jinsu1011/2026ESWContest_free_GaManItSeoDo-SANDI/final-report/README.md

# final-report

제24회 임베디드SW경진대회(2026) 자유공모 부문 **개발완료보고서** 제출본과
보고서에 사용한 원본 이미지 자산을 보관하는 폴더다.

| 파일 | 설명 |
|---|---|
| `2026ESWContest_자유공모_가만있어도SANDI_개발완료보고서.pdf` | 제출용 PDF (표지 1 + 본문 20 = 21페이지) |
| `assets/` | 보고서에 사용한 하드웨어·UI·3D 하우징 사진 및 렌더 |

`assets/` 주요 항목

| 파일 | 내용 |
|---|---|
| `hw_product_final.jpg`, `hw_product_full_crop.jpg` | 통합 완제품 외형 |
| `hw_product_full_emergency.jpg`, `hw_product_emergency_crop.jpg` | 긴급 상태 표시 |
| `hw_node_final.png` | 센서 노드 배선도 |
| `hw_esp32_wiring.jpg`, `hw_bench.jpg` | ESP32 실물 배선과 벤치 |
| `ui_lcd_1_normal_empty.jpg` ~ `ui_lcd_6_failed.jpg` | LCD 6개 상태 화면 |
| `ui_web.png` | 관리자 웹 화면 |
| `3d_*.png` | 3D 하우징 설계 렌더 (STL 원본은 `hardware/3d_models/`) |
| `thermal_spotcheck.jpg` | Thermal 현장 점검 |
| `qr_confined.png` | 게스트 대시보드 QR |
