jinsu1011/2026ESWContest_free_GaManItSeoDo-SANDI/final-report/assets/3d_lcd_housing_front.png

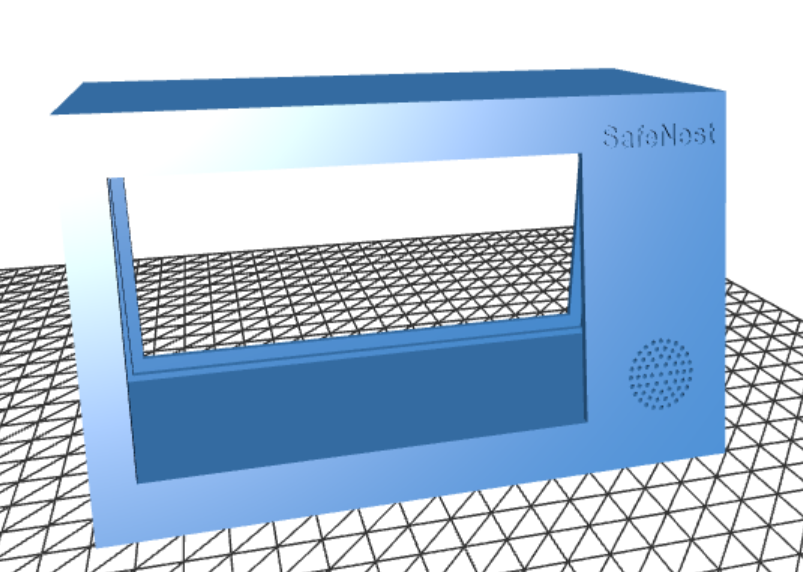
final-report/assets/3d_lcd_housing_front.png
