jinsu1011/2026ESWContest_free_GaManItSeoDo-SANDI/final-report/assets/3d_sensor_housing_sliding_back.png

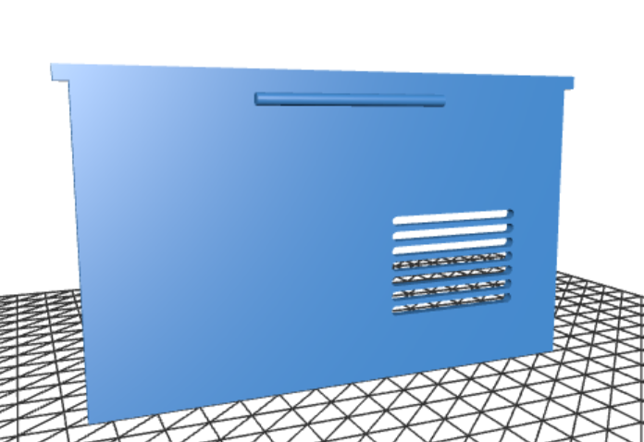
final-report/assets/3d_sensor_housing_sliding_back.png
