jinsu1011/2026ESWContest_free_GaManItSeoDo-SANDI/final-report/assets/3d_trapezoid_T_back_vent.png

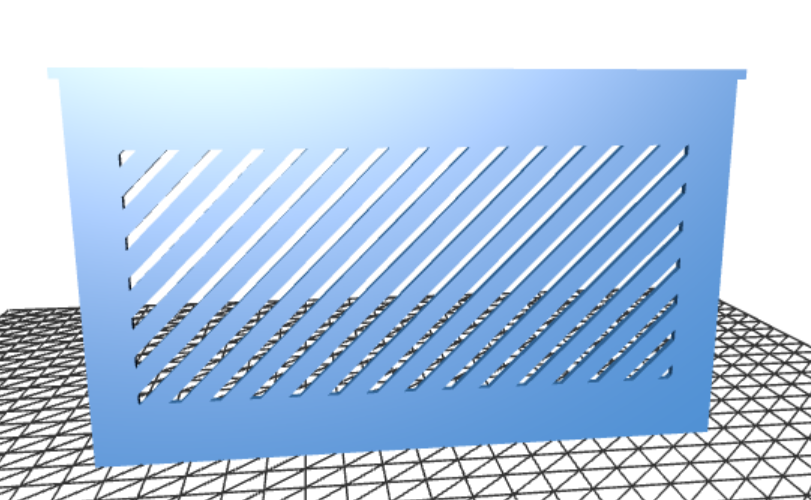
final-report/assets/3d_trapezoid_T_back_vent.png
