jinsu1011/2026ESWContest_free_GaManItSeoDo-SANDI/final-report/assets/hw_bench.jpg

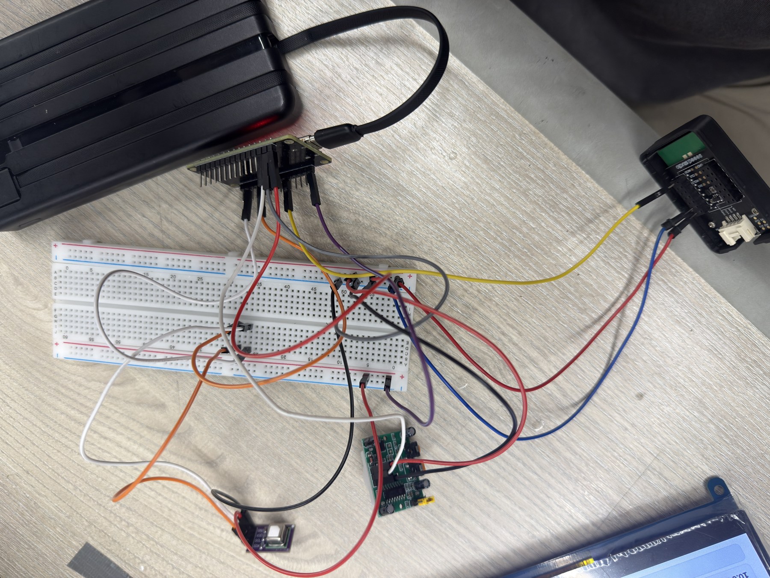
final-report/assets/hw_bench.jpg
