jinsu1011/2026ESWContest_free_GaManItSeoDo-SANDI/final-report/assets/hw_product_full_crop.jpg

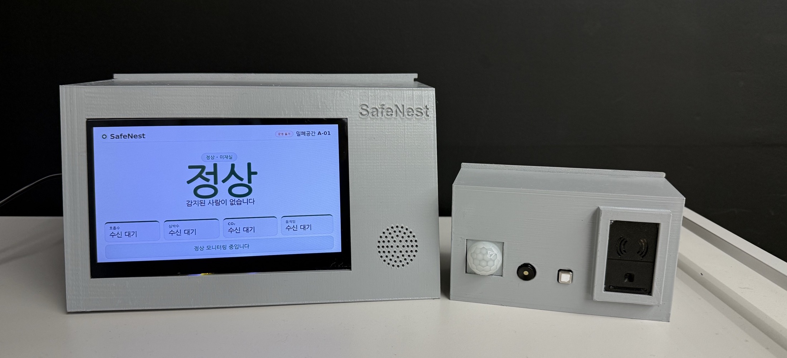
final-report/assets/hw_product_full_crop.jpg
