jinsu1011/2026ESWContest_free_GaManItSeoDo-SANDI/final-report/assets/qr_confined.png

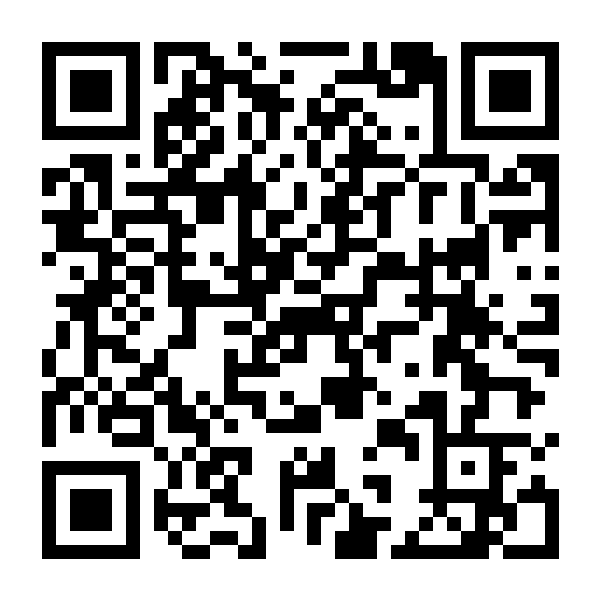
final-report/assets/qr_confined.png
