jinsu1011/2026ESWContest_free_GaManItSeoDo-SANDI/final-report/assets/thermal_spotcheck.jpg

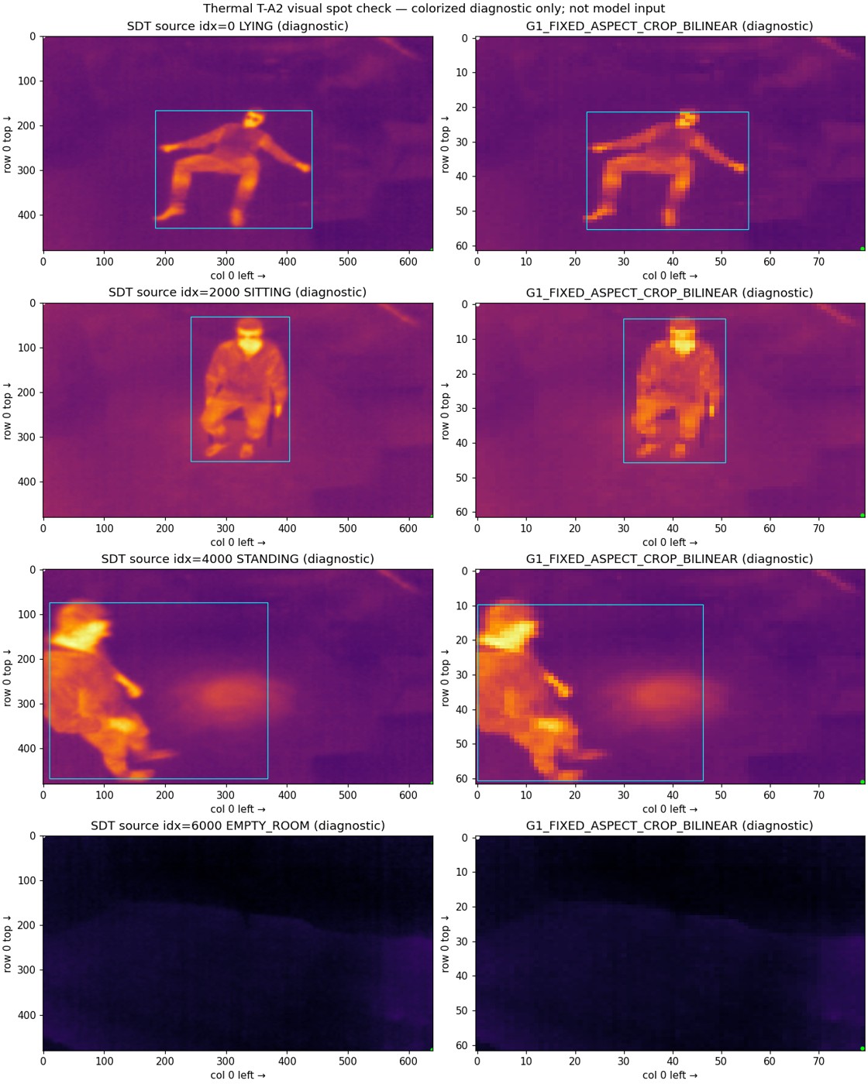
final-report/assets/thermal_spotcheck.jpg
