jinsu1011/2026ESWContest_free_GaManItSeoDo-SANDI/final-report/assets/ui_lcd_1_normal_empty.jpg

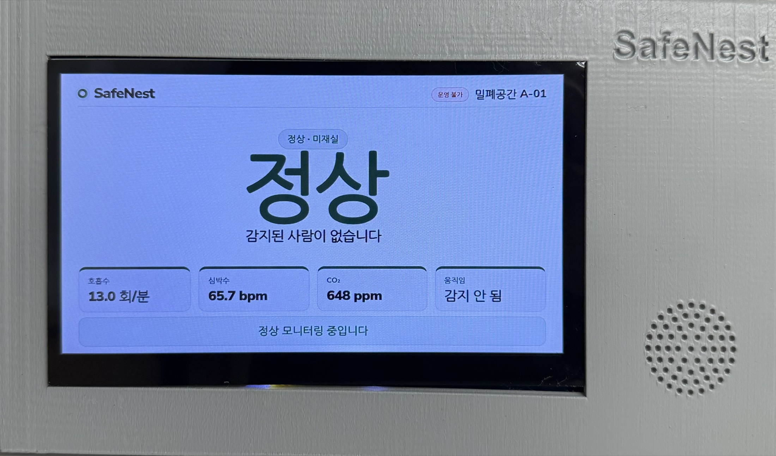
final-report/assets/ui_lcd_1_normal_empty.jpg
