jinsu1011/2026ESWContest_free_GaManItSeoDo-SANDI/final-report/assets/ui_lcd_3_caution.jpg

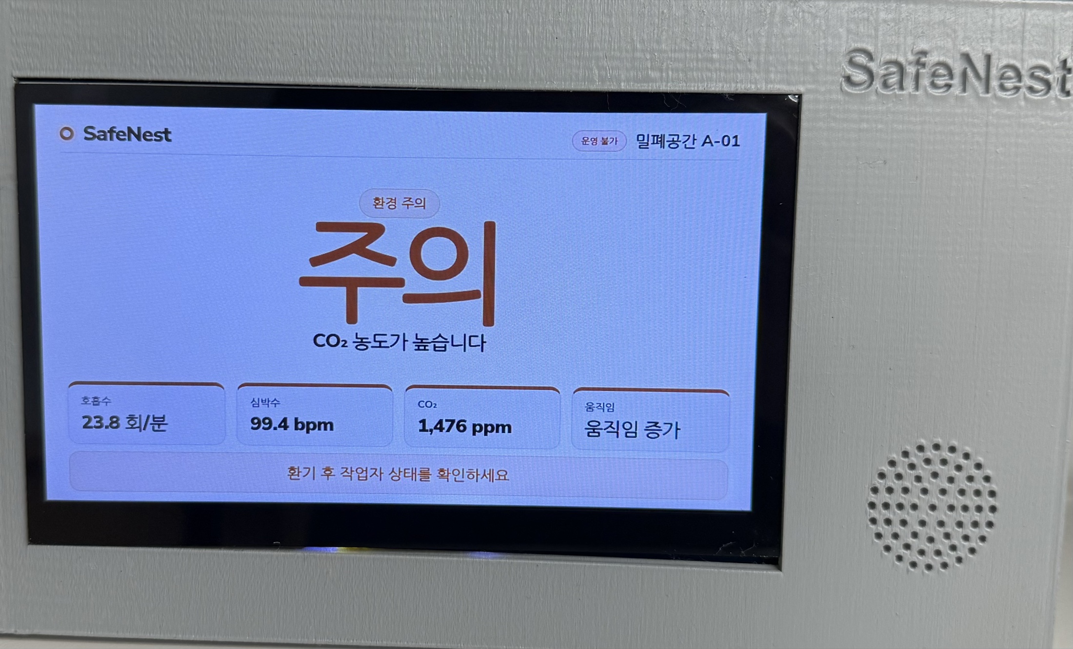
final-report/assets/ui_lcd_3_caution.jpg
