jinsu1011/2026ESWContest_free_GaManItSeoDo-SANDI/final-report/assets/ui_lcd_6_failed.jpg

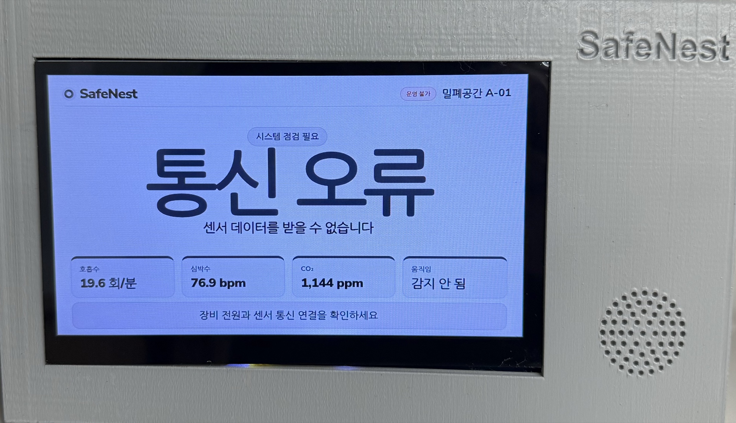
final-report/assets/ui_lcd_6_failed.jpg
