jinsu1011/2026ESWContest_free_GaManItSeoDo-SANDI/hardware/3d_models/housing_body.stl

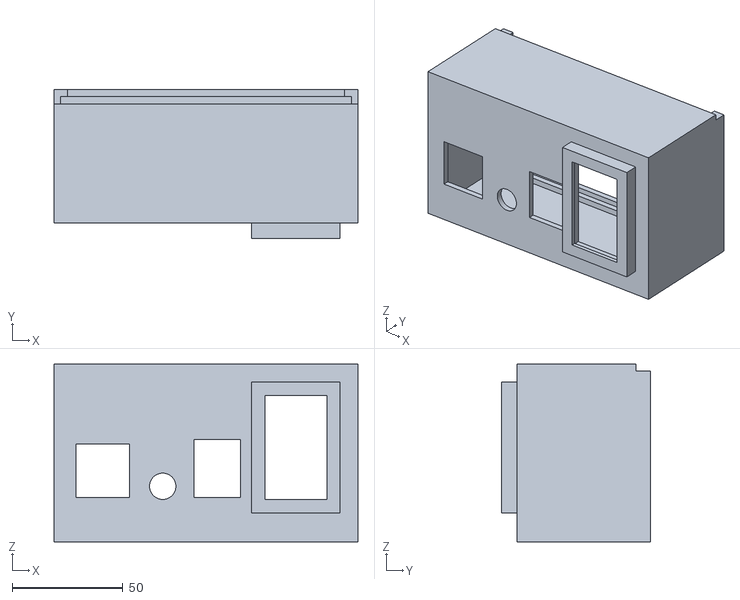
[picture p43: CAD file, 2026-09-02]
hardware/3d_models/housing_body.stl
137.0 x 67.0 x 80.0
