jinsu1011/2026ESWContest_free_GaManItSeoDo-SANDI/hardware/3d_models/sliding_back_panel.stl

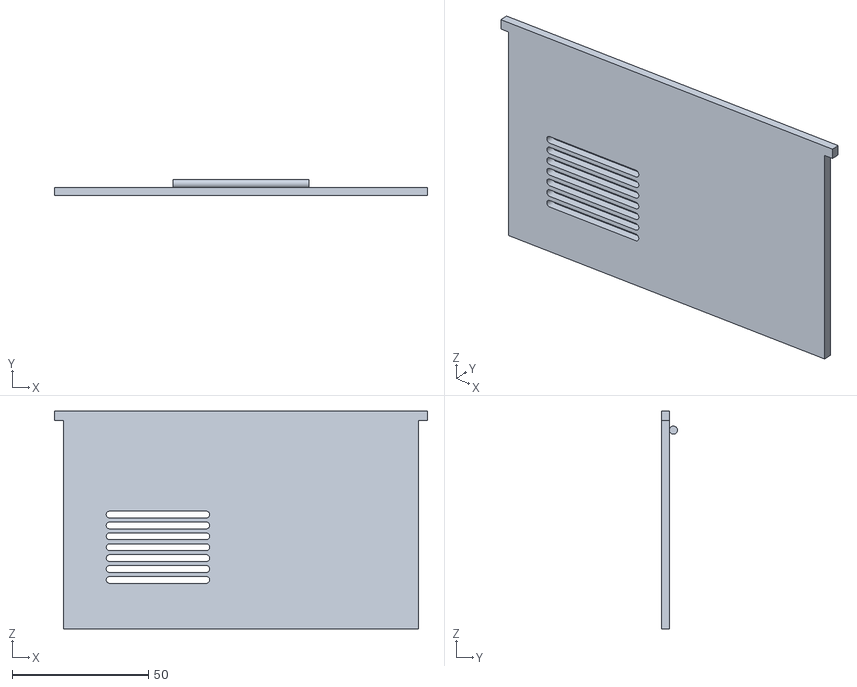
[picture p44: CAD file, 2026-09-02]
hardware/3d_models/sliding_back_panel.stl
137.0 x 5.90 x 80.0
