jinsu1011/2026ESWContest_free_GaManItSeoDo-SANDI/hardware/3d_models/trapezoid_T_back_panel.stl

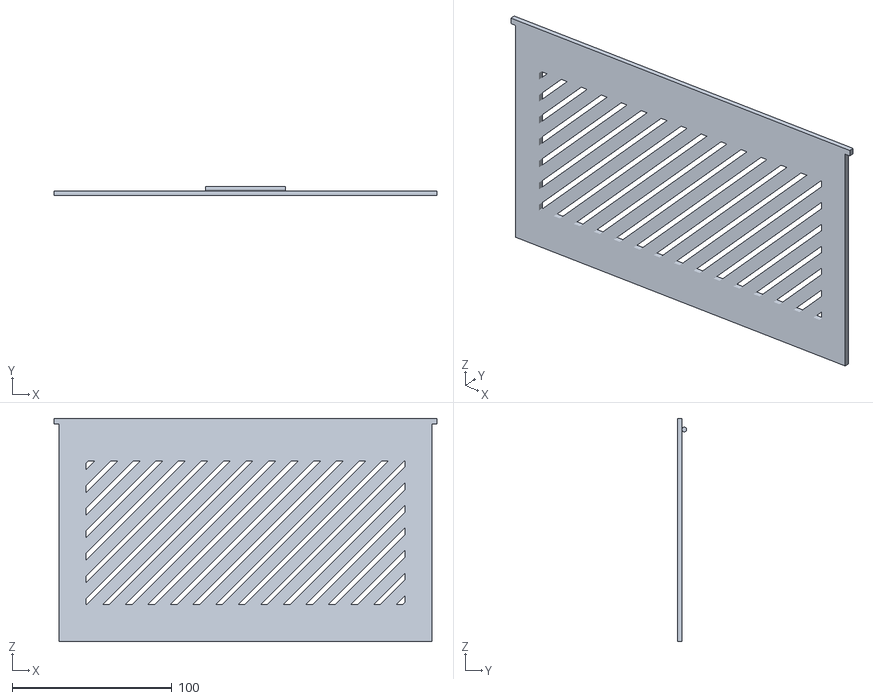
[picture p45: CAD file, 2026-09-02]
hardware/3d_models/trapezoid_T_back_panel.stl
240.0 x 5.90 x 140.0
