jinsu1011/2026ESWContest_free_GaManItSeoDo-SANDI/hardware/3d_models/trapezoid_housing_body.stl

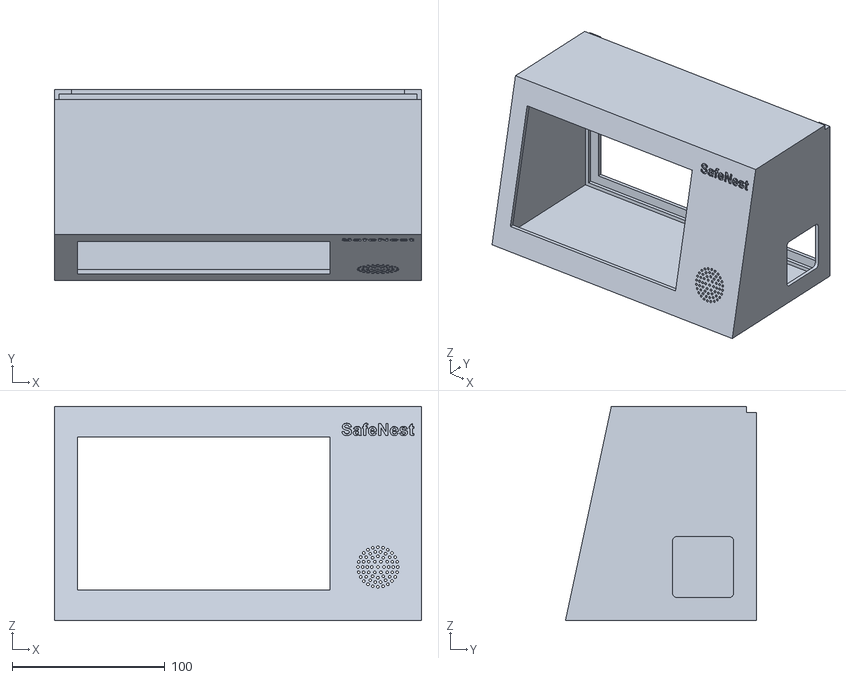
[picture p46: CAD file, 2026-09-02]
hardware/3d_models/trapezoid_housing_body.stl
240.0 x 125.0 x 140.0
