jinsu1011/2026ESWContest_free_GaManItSeoDo-SANDI/final-report/assets/hw_esp32_wiring.jpg

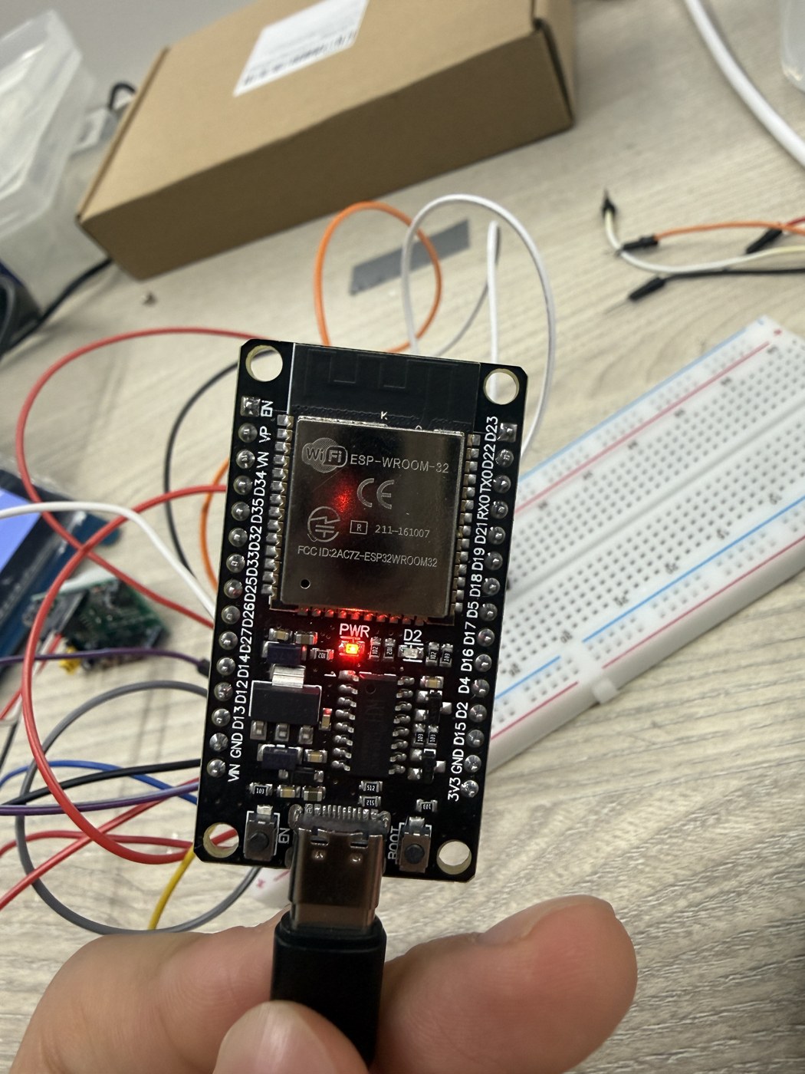
final-report/assets/hw_esp32_wiring.jpg
